marcelbonnici/times-tables-homework-machine/bwimage.png

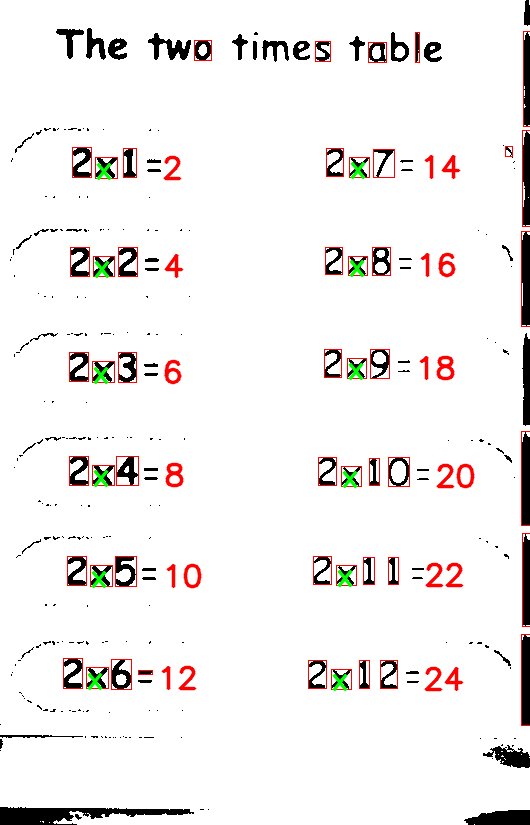
bwimage.png
