marcelbonnici/times-tables-homework-machine/limages/sheet.png

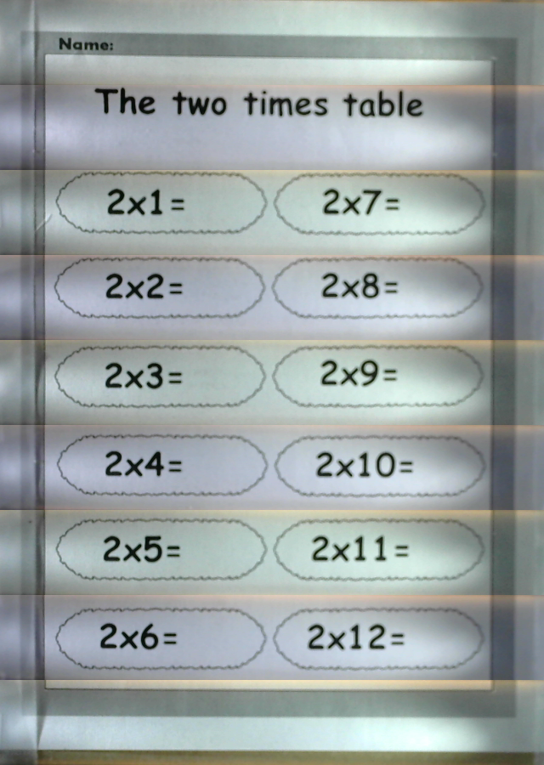
limages/sheet.png
