marcelbonnici/times-tables-homework-machine/(commit log)

2020-01-13 Added all files I completed for the LEGO/prototype version
2020-01-13 Updated README with current progress
2020-01-14 Made my LEGO prototype able to successfully run what is completed so far
